bence-sebok/thesis/pictures/dht22 data waveform.png

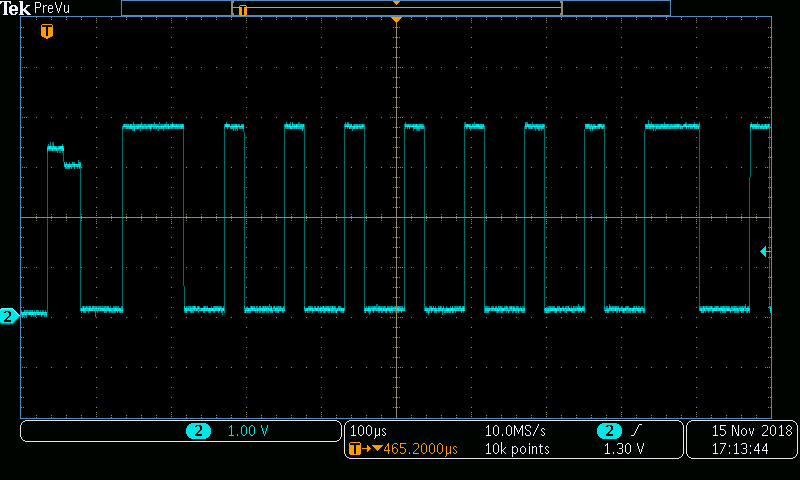
pictures/dht22 data waveform.png
