bence-sebok/thesis/pictures/ezr32lg_board.png

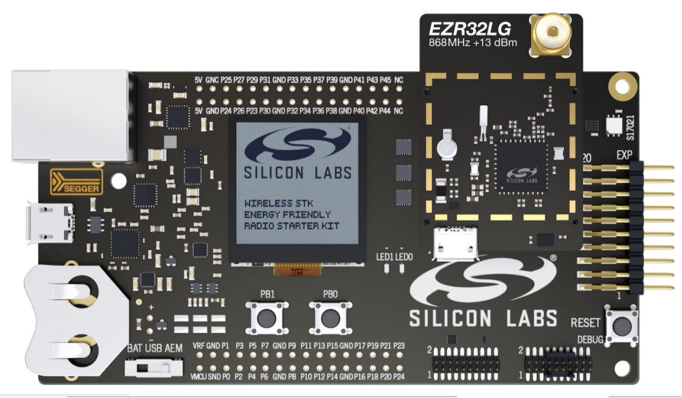
pictures/ezr32lg_board.png
