bence-sebok/thesis/pictures/i2c waveform 3.png

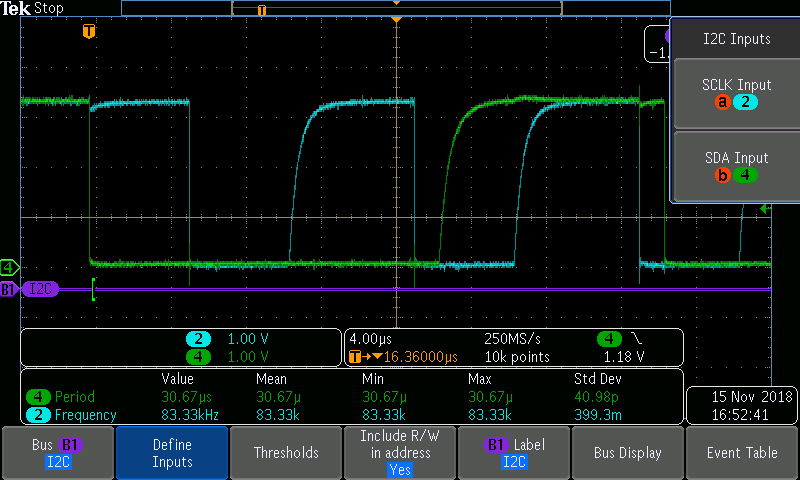
pictures/i2c waveform 3.png
