bence-sebok/thesis/pictures/i2c waveform.png

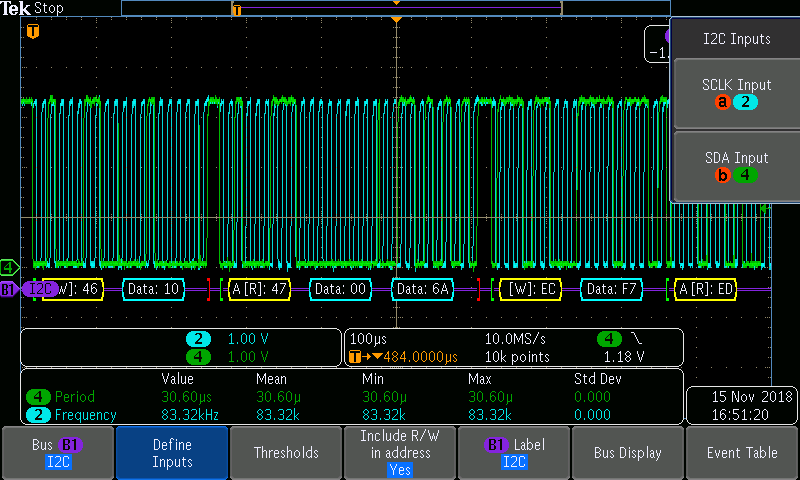
pictures/i2c waveform.png
