bence-sebok/thesis/pictures/img_bh1750_block.png

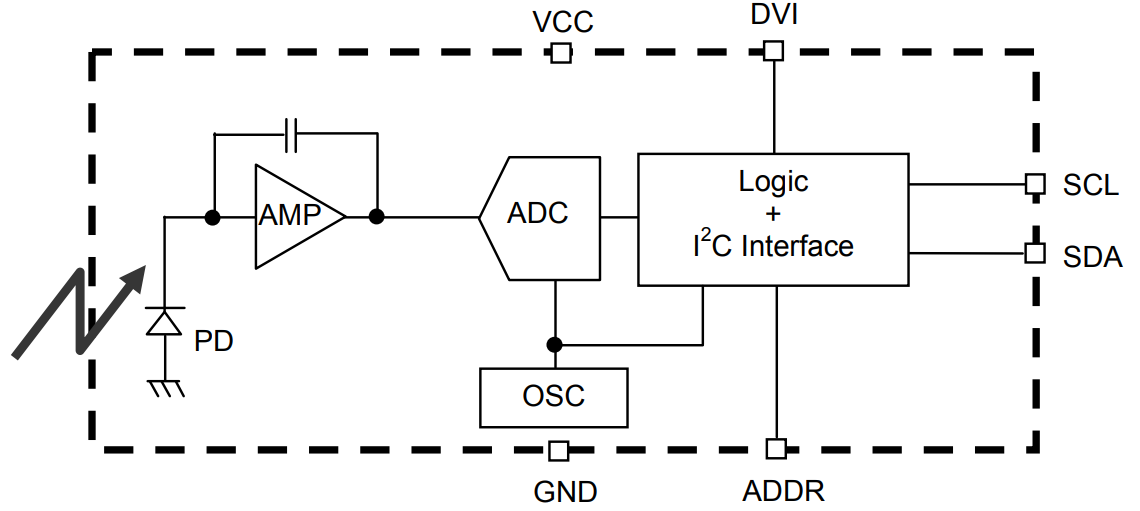
pictures/img_bh1750_block.png
