bence-sebok/thesis/pictures/img_bh1750_mode.png

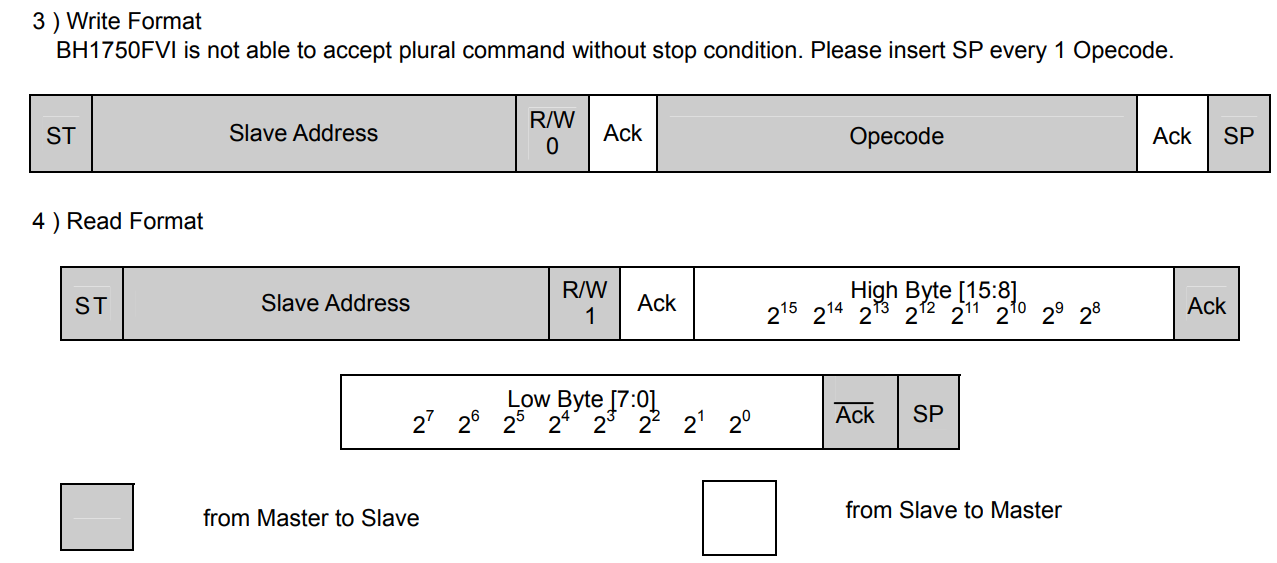
pictures/img_bh1750_mode.png
