bence-sebok/thesis/pictures/img_bh1750fvi.png

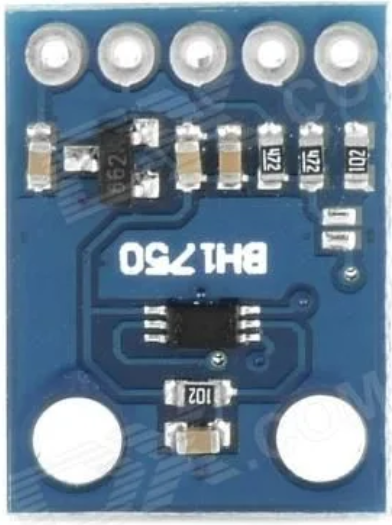
pictures/img_bh1750fvi.png
