bence-sebok/thesis/pictures/img_bmp280.png

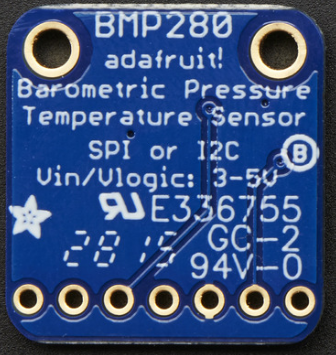
pictures/img_bmp280.png
