bence-sebok/thesis/pictures/img_bmp280_block.png

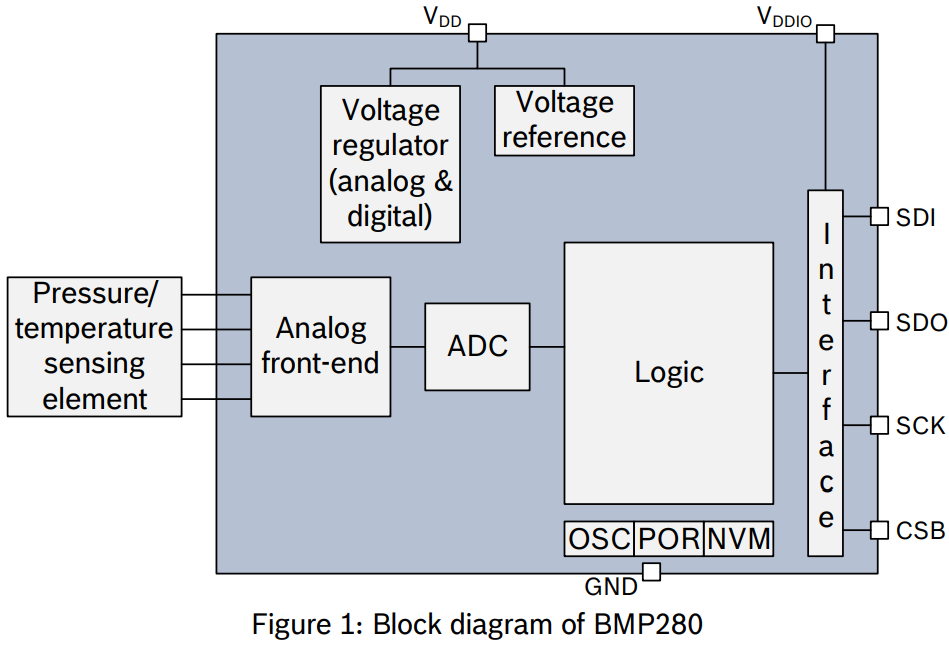
pictures/img_bmp280_block.png
