bence-sebok/thesis/pictures/img_bmp280_meas.png

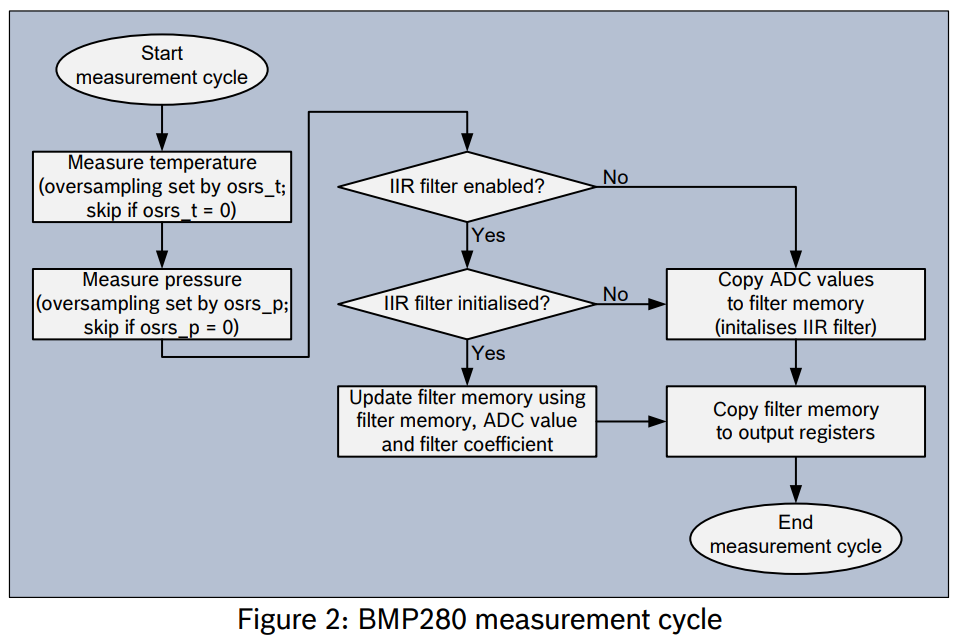
pictures/img_bmp280_meas.png
