bence-sebok/thesis/pictures/img_dht22.png

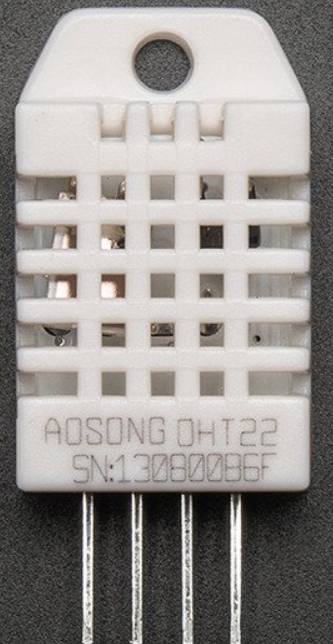
pictures/img_dht22.png
