bence-sebok/thesis/pictures/img_fsk.png

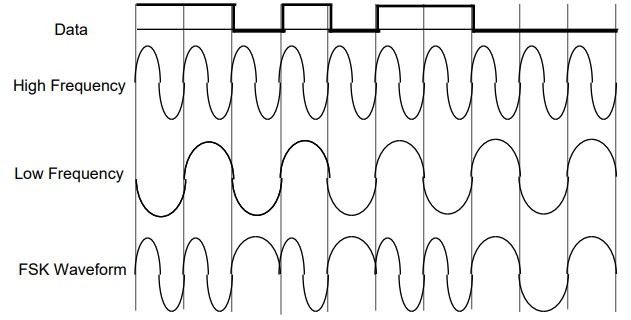
pictures/img_fsk.png
