bence-sebok/thesis/software/gecko/thesis_gecko/inc/hardware_config.h

/*
 * hardware_config.h
 *
 *  Created on: Nov 15, 2018
 *      Author: sebokbence
 */

#ifndef INC_HARDWARE_CONFIG_H_
#define INC_HARDWARE_CONFIG_H_

#define I2C0_SDA_PORT (gpioPortD)
#define I2C0_SDA_PIN (6U)
#define I2C0_SCL_PORT (gpioPortD)
#define I2C0_SCL_PIN (7U)

#endif /* INC_HARDWARE_CONFIG_H_ */
