bence-sebok/thesis/software/gecko/thesis_gecko/src/main.c

/***************************************************************************//**
 * @file main.c
 * @brief EZRadio simple trx example
 *
 * This example shows how to easily implement a simple trx code for your
 * controller using EZRadio or EZRadioPRO devices.
 *
 * @version 5.2.2
 *******************************************************************************
 * # License
 * <b>Copyright 2015 Silicon Labs, Inc. http://www.silabs.com</b>
 *******************************************************************************
 *
 * Permission is granted to anyone to use this software for any purpose,
 * including commercial applications, and to alter it and redistribute it
 * freely, subject to the following restrictions:
 *
 * 1. The origin of this software must not be misrepresented; you must not
 *    claim that you wrote the original software.
 * 2. Altered source versions must be plainly marked as such, and must not be
 *    misrepresented as being the original software.
 * 3. This notice may not be removed or altered from any source distribution.
 *
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
 * Silicon Labs will not be liable for any consequential, incidental, or
 * special damages, or any other relief, or for any claim by any third party,
 * arising from your use of this Software.
 *
 ******************************************************************************/

//#define THESIS_TEST
#define USING_DISPLAY

#include <stdint.h>
#include <stdbool.h>
#include <stdio.h>
#include <stdlib.h>
#include <string.h>

#include "spidrv.h"
#include "em_device.h"
#include "em_chip.h"
#include "em_cmu.h"
#include "em_emu.h"
#include "em_gpio.h"
#include "em_i2c.h"
#include "em_timer.h"
#include "gpiointerrupt.h"
#include "rtcdriver.h"
#include "udelay.h"

#include "ezradio_cmd.h"
#include "ezradio_api_lib.h"
#include "ezradio_plugin_manager.h"

#include "display.h"
#include "textdisplay.h"
#include "retargettextdisplay.h"
#include "bspconfig.h"
#include "image.h"

// Header files for sensors
#include "hardware_config.h"
#include "FH1750.h"
#include "BMP280.h"
#include "DHT22.h"

int8_t BMP280_CHIPID_VALUE[1] = {0};
uint16_t chipidSize = 1;

int8_t BMP280_CONFIG[2] = {0};
uint16_t sizeConfig = 2;

uint32_t bmp280_pressure = 0;
int32_t bmp280_temperature = 0;
double bmp280_temperature_C = 0.0;

uint16_t lightLevel = 0;

uint8_t meas[6] = {0};

dht22_data_t dht22_data = {0};

struct bmp280_calib_param bmp280_parameters = {0};

volatile int32_t measurement_press = 0;
volatile int32_t measurement_temp = 0;

// FH1750 global variables
uint32_t rxBuffer[100];
uint8_t rxIndex = 0;
volatile uint8_t BH1750_MODE = CONTINUOUS_HIGH_RES_MODE;
volatile uint8_t BH1750_MTreg = 0;
const float BH1750_CONV_FACTOR = 1.2;

/* Display device */
static DISPLAY_Device_t displayDevice;

/* Image widht and height definitions */
#define IMAGE_HIGHT           62u
#define BYTES_PER_LINE        (LS013B7DH03_WIDTH / 8)
#define BYTES_PER_FRAME       (IMAGE_HIGHT * BYTES_PER_LINE)

/* Push button callback functionns. */
static void GPIO_PB1_IRQHandler(uint8_t pin);
static void GPIO_PB0_IRQHandler(uint8_t pin);

#if (defined EZRADIO_VARIABLE_DATA_START)
#define APP_PKT_DATA_START EZRADIO_VARIABLE_DATA_START
#else
#define APP_PKT_DATA_START 1u
#endif

#if (defined EZRADIO_PLUGIN_TRANSMIT)
static void appPacketTransmittedCallback (EZRADIODRV_Handle_t handle, Ecode_t status);
#endif //#if ( defined EZRADIO_PLUGIN_TRANSMIT )

#if (defined EZRADIO_PLUGIN_RECEIVE)
static void appPacketReceivedCallback (EZRADIODRV_Handle_t handle, Ecode_t status);
#endif //#if ( defined EZRADIO_PLUGIN_RECEIVE )

#if (defined EZRADIO_PLUGIN_CRC_ERROR)
static void appPacketCrcErrorCallback (EZRADIODRV_Handle_t handle, Ecode_t status);
#endif //#if ( defined EZRADIO_PLUGIN_CRC_ERROR )

#if !defined(__CROSSWORKS_ARM) && defined(__GNUC__)
/* sniprintf does not process floats, but occupy less flash memory ! */
#define snprintf    sniprintf
#endif

#if (defined EZRADIO_PLUGIN_TRANSMIT)

/* Defines the number of packets to send for one press of PB1.
 * Sends infinite number of packets if defined to 0xFFFF. */
#define APP_TX_PKT_SEND_NUM   0xFFFF

/* Tx packet data array, initialized with the default payload in the generated header file */
static uint8_t radioTxPkt[EZRADIO_FIFO_SIZE] = RADIO_CONFIG_DATA_CUSTOM_PAYLOAD;

/* Packet counter */
static volatile uint16_t appTxPktCntr = 0;

/* Sign tx active state */
static volatile bool appTxActive = false;

/* Data counter in transmitted packet */
static volatile uint16_t appDataCntr = 0;

#endif //#if ( defined EZRADIO_PLUGIN_TRANSMIT )

#if (defined EZRADIO_PLUGIN_RECEIVE)

/* Rx packet data array */
static uint8_t radioRxPkt[EZRADIO_FIFO_SIZE];

#endif //#if ( defined EZRADIO_PLUGIN_RECEIVE )

/* RTC frequency */
#if defined(_EZR32_HAPPY_FAMILY)
#define APP_RTC_FREQ_HZ 4u
#else
#define APP_RTC_FREQ_HZ 9u
#endif

/* RTC timeout */
#define APP_RTC_TIMEOUT_MS (1000u / APP_RTC_FREQ_HZ)

/* RTC set time is expired */
static volatile bool rtcTick = false;

/** Timer used to issue time elapsed interrupt. */
static RTCDRV_TimerID_t rtcTickTimer;
static RTCDRV_TimerID_t rtcRepeateTimer;

static volatile uint32_t timerTick = 0;
static volatile uint8_t measurementFlag = 0;

/**************************************************************************//**
 * @brief
 *    TIMER initialization
 *****************************************************************************/
// Note: change this to set the desired output frequency in Hz
#define TIMER_FREQ (0.2)
void initTimer(void)
{
  // Enable clock for TIMER0 module
  CMU_ClockEnable(cmuClock_TIMER1, true);

  // Initialize the timer
  TIMER_Init_TypeDef timerInit = TIMER_INIT_DEFAULT;
  timerInit.prescale = _TIMER_CTRL_PRESC_DIV1024;
  TIMER_Init(TIMER1, &timerInit);

  // Set top value to overflow at the desired PWM_FREQ frequency
  TIMER_TopSet(TIMER1,  250000000);


  // Enable TIMER0 compare event interrupts to update the duty cycle
  TIMER_IntEnable(TIMER1, TIMER_IEN_OF);
  NVIC_EnableIRQ(TIMER1_IRQn);
}

/**************************************************************************//**
 * @brief
 *    Interrupt handler for TIMER1 that changes the duty cycle
 *******************************************************************************/
void TIMER1_IRQHandler(void)
{
  // Acknowledge the interrupt
  uint32_t flags = TIMER_IntGet(TIMER1);
  TIMER_IntClear(TIMER1, flags);
  timerTick++;
  if(timerTick > 10)
  {
	  measurementFlag = 1;
	  GPIO_PinOutToggle(gpioPortF, 6);
	  timerTick = 0;
  }
}

/***************************************************************************//**
 * @brief Setup GPIO interrupt for pushbuttons.
 ******************************************************************************/
static void GpioSetup(void)
{
  /* Enable GPIO clock */
  CMU_ClockEnable(cmuClock_GPIO, true);

  /* Initialize GPIO interrupt */
  GPIOINT_Init();

  /* Configure PB0 as input and enable interrupt */
  GPIO_PinModeSet(BSP_GPIO_PB0_PORT, BSP_GPIO_PB0_PIN, gpioModeInputPull, 1);
  GPIO_IntConfig(BSP_GPIO_PB0_PORT, BSP_GPIO_PB0_PIN, false, true, true);
  GPIOINT_CallbackRegister(BSP_GPIO_PB0_PIN, GPIO_PB0_IRQHandler);

  /* Configure PB1 as input and enable interrupt */
  GPIO_PinModeSet(BSP_GPIO_PB1_PORT, BSP_GPIO_PB1_PIN, gpioModeInputPull, 1);
  GPIO_IntConfig(BSP_GPIO_PB1_PORT, BSP_GPIO_PB1_PIN, false, true, true);
  GPIOINT_CallbackRegister(BSP_GPIO_PB1_PIN, GPIO_PB1_IRQHandler);

  // DHT22 sensor GPIO settings
  GPIO_PinModeSet(DHT22_DATA_PORT, DHT22_DATA_PIN, gpioModeInputPull, 1); // Pull up

  GPIO_PinModeSet(gpioPortF, 6, gpioModePushPull, 1); // User LED0
  GPIO_PinModeSet(gpioPortF, 7, gpioModePushPull, 0); // User LED1
}

/***************************************************************************//**
 * @brief GPIO Interrupt handler (PB1)
 *        Switches between analog and digital clock modes.
 ******************************************************************************/
static void GPIO_PB0_IRQHandler(uint8_t pin)
{
  (void)pin;

#if (defined EZRADIO_PLUGIN_TRANSMIT)
  /* Check if already transmitting some packets,
   * send one otherwise. */
  if ( !appTxPktCntr ) {
    appTxPktCntr += 1;
  }
#endif //#if ( defined EZRADIO_PLUGIN_TRANSMIT )
}

static void doMeasurement(void)
{
	int i;
	int empty = false;
	GPIO_PinOutSet(gpioPortF, 7);
	BH1750_readLightLevel(1000, &lightLevel);
	BMP280_I2C_ReadRegister(0xF7, (int8_t*)meas, 6);
	for(i = 0; i < 6; i++)
	{
		if(meas[i] != 0)
		{
			empty = true;
		}
	}
	if(!empty)
	{
		meas[0] = 0b111;
		meas[1] = 0b11101110;
		meas[3] = 0b11010000;
		meas[4] = 0b110;
		meas[5] = 0b01010101;
		meas[6] = 0b10101100;
	}
	measurement_press = (int32_t) (((uint32_t)meas[0] << 12) | ((uint32_t)meas[1] << 4) | ((uint32_t)meas[2] >> 4));
	measurement_temp = (int32_t) (((int32_t)meas[3] << 12) | ((int32_t)meas[4] << 4) | ((int32_t)meas[5] >> 4));
	bmp280_temperature = BMP280_CompensateTemperature(measurement_temp, &bmp280_parameters);
	bmp280_pressure = BMP280_CompensatePressure(measurement_press, &bmp280_parameters);
	bmp280_temperature_C = ((double)bmp280_temperature) / 100;
	if(DHT22_ReadSensor(&dht22_data))
	{
		DHT22_GetTemperature(&dht22_data);
		DHT22_GetHumidity(&dht22_data);
		DHT22_ComputeHeatIndex(&dht22_data);
	}
	memset(radioTxPkt, 0, 64);
	/* Add data cntr as the data to be sent to the packet */
	// Light level
	radioTxPkt[APP_PKT_DATA_START]   = (uint8_t)( ((uint16_t)lightLevel) >> 8);
	radioTxPkt[APP_PKT_DATA_START + 1] = (uint8_t)( ((uint16_t)lightLevel) & 0x00FF);
	// BMP280 temperature
	radioTxPkt[APP_PKT_DATA_START + 2]   = (uint8_t)( ((uint16_t)(bmp280_temperature)) >> 24 & 0x00FF);
	radioTxPkt[APP_PKT_DATA_START + 3]   = (uint8_t)( ((uint16_t)(bmp280_temperature)) >> 16 & 0x00FF);
	radioTxPkt[APP_PKT_DATA_START + 4]   = (uint8_t)( ((uint16_t)(bmp280_temperature)) >> 8 & 0x00FF);
	radioTxPkt[APP_PKT_DATA_START + 5]   = (uint8_t)( ((uint16_t)(bmp280_temperature)) >> 0 & 0x00FF);
	// BMP280 pressure
	radioTxPkt[APP_PKT_DATA_START + 6]   = (uint8_t)( ((uint16_t)(bmp280_pressure)) >> 24 & 0x00FF);
	radioTxPkt[APP_PKT_DATA_START + 7]   = (uint8_t)( ((uint16_t)(bmp280_pressure)) >> 16 & 0x00FF);
	radioTxPkt[APP_PKT_DATA_START + 8]   = (uint8_t)( ((uint16_t)(bmp280_pressure)) >> 8 & 0x00FF);
	radioTxPkt[APP_PKT_DATA_START + 9]   = (uint8_t)( ((uint16_t)(bmp280_pressure)) >> 0 & 0x00FF);
	/*
	memset(radioTxPkt, 0, 64);
	radioTxPkt[APP_PKT_DATA_START]   = (uint8_t)( ((uint16_t)1) >> 8);
	radioTxPkt[APP_PKT_DATA_START + 1] = (uint8_t)( ((uint16_t)1) & 0x00FF);
	// BMP280 temperature
	radioTxPkt[APP_PKT_DATA_START + 2]   = (uint8_t)( ((uint16_t)(2 / 100)) >> 8);
	radioTxPkt[APP_PKT_DATA_START + 3] = (uint8_t)( ((uint16_t)(2 % 100)) & 0x00FF);
	// BMP280 pressure
	radioTxPkt[APP_PKT_DATA_START + 4]   = (uint8_t)( ((uint16_t)(3 / 100)) >> 8);
	radioTxPkt[APP_PKT_DATA_START + 5] = (uint8_t)( ((uint16_t)(3 % 100)) & 0x00FF);
	*/
	GPIO_PinOutClear(gpioPortF, 7);
	appTxPktCntr += 1;
}

/***************************************************************************//**
 * @brief GPIO Interrupt handler (PB0)
 *        Increments the time by one minute.
 ******************************************************************************/
static void GPIO_PB1_IRQHandler(uint8_t pin)
{
  (void)pin;

#if (defined EZRADIO_PLUGIN_TRANSMIT)
  /* Check if already transmitting some packets, stop them if so,
   * otherwise, send the APP_TX_PKT_SEND_NUM number of packets
   * (infinite is defined to 0xFFFF). */
  /*
  if (appTxPktCntr) {
    appTxPktCntr = 0;
  } else {
    appTxPktCntr += APP_TX_PKT_SEND_NUM;
  }
  */
#endif //#if ( defined EZRADIO_PLUGIN_TRANSMIT )
}

/***************************************************************************//**
 * @brief Draws Silicon Labs logo.
 ******************************************************************************/
void drawPicture(void)
{
  char *pFrame;

  /* Retrieve the properties of the display. */
  if ( DISPLAY_DeviceGet(0, &displayDevice) != DISPLAY_EMSTATUS_OK) {
    while (1) ;
  }

  /* Load pointer to picture buffor */
  pFrame = (char *) image_bits;

  /* Write to LCD */
  displayDevice.pPixelMatrixDraw(&displayDevice, pFrame,
                                 /* start coloumn, width */
                                 0, displayDevice.geometry.width,
                                 /* start row, height */
                                 0, IMAGE_HIGHT);
}

/***************************************************************************//**
 * @brief   Register a callback function to be called repeatedly at the
 *          specified frequency.
 *
 * @param[in] pFunction  Pointer to function that should be called at the
 *                       given frequency.
 * @param[in] pParameter Pointer argument to be passed to the callback function.
 * @param[in] frequency  Frequency at which to call function at.
 *
 * @return  0 for successful or
 *         -1 if the requested frequency is not supported.
 ******************************************************************************/
int RepeatCallbackRegister(void(*pFunction)(void*),
                           void* pParameter,
                           unsigned int frequency)
{
  if (ECODE_EMDRV_RTCDRV_OK
      == RTCDRV_AllocateTimer(&rtcRepeateTimer)) {
    if (ECODE_EMDRV_RTCDRV_OK
        == RTCDRV_StartTimer(rtcRepeateTimer, rtcdrvTimerTypePeriodic, frequency,
                             (RTCDRV_Callback_t)pFunction, pParameter)) {
      return 0;
    }
  }

  return -1;
}

/***************************************************************************//**
 * @brief GPIO Interrupt handler (PB0)
 *        Increments the time by one minute.
 ******************************************************************************/
void RTC_App_IRQHandler()
{
  rtcTick = true;
}

void initI2C(void)
{
  int i;
  CMU_Clock_TypeDef i2cClock;
  I2C_Init_TypeDef i2cInit = I2C_INIT_DEFAULT;

  CMU_ClockEnable(cmuClock_HFPER, true);
  /* Select I2C peripheral clock */
  i2cClock = cmuClock_I2C0;
  CMU_ClockEnable(i2cClock, true);

  /* Output value must be set to 1 to not drive lines low. Set
	 SCL first, to ensure it is high before changing SDA. */
  GPIO_PinModeSet(gpioPortD, 7, gpioModeWiredAndPullUp, 1);
  GPIO_PinModeSet(gpioPortD, 6, gpioModeWiredAndPullUp, 1);

  /* In some situations, after a reset during an I2C transfer, the slave
	 device may be left in an unknown state. Send 9 clock pulses to
	 set slave in a defined state. */
  for (i = 0; i < 9; i++) {
	GPIO_PinOutSet(gpioPortD, 7);
	GPIO_PinOutClear(gpioPortD, 7);
  }

  /* Enable pins and set location */
  I2C0->ROUTE = I2C_ROUTE_SDAPEN | I2C_ROUTE_SCLPEN | (1 << _I2C_ROUTE_LOCATION_SHIFT);

  I2C_Init(I2C0, &i2cInit);
}

/***************************************************************************//**
 * @brief  Main function of the example.
 ******************************************************************************/
int main(void)
{
  /* EZRadio driver init data and handler */
  EZRADIODRV_HandleData_t appRadioInitData = EZRADIODRV_INIT_DEFAULT;
  EZRADIODRV_Handle_t appRadioHandle = &appRadioInitData;

  /* EZRadio response structure union */
  ezradio_cmd_reply_t ezradioReply;

  uint8_t BMP280_RESET[1] = {0xB6};

  /* Chip errata */
  CHIP_Init();

  /* HFXO 48MHz, divided by 1 */
  CMU_ClockSelectSet(cmuClock_HF, cmuSelect_HFXO);
  UDELAY_Calibrate();

  /* Setup GPIO for pushbuttons. */
  GpioSetup();

  initI2C();

  BH1750_Configure(CONTINUOUS_HIGH_RES_MODE);
  BMP280_I2C_ReadRegister(BMP280_CHIPID_REGISTER, BMP280_CHIPID_VALUE, chipidSize);
  if(BMP280_CHIPID_VALUE[0] == 88 || BMP280_CHIPID_VALUE[0] == 0x58)
  {
	  BMP280_I2C_WriteRegister(0xE0, (int8_t*)BMP280_RESET, 1);
  }
  UDELAY_Delay(1000);
  UDELAY_Delay(1000);
  UDELAY_Delay(1000);
  UDELAY_Delay(1000);
  UDELAY_Delay(1000);
  BMP280_I2C_ReadRegister(BMP280_CHIPID_REGISTER, BMP280_CHIPID_VALUE, chipidSize);
  BMP280_GetCalibrationParameters(&bmp280_parameters);
  BMP280_I2C_ReadRegister(0xF4, BMP280_CONFIG, sizeConfig);
  delay_ms(1000);
  BMP280_CONFIG[0] = ((0x05 << 2) | (0x03 << 5));
  BMP280_CONFIG[1] = ((0x05 << 5) | (0x01 << 2));
  BMP280_I2C_WriteRegister(0xF4, BMP280_CONFIG, 2);
  BMP280_CONFIG[0] = ((0x05 << 2) | (0x03 << 5) | (0x03));
  BMP280_I2C_WriteRegister(0xF4, BMP280_CONFIG, 2);

#ifdef THESIS_TEST
  while(1)
  {
	  doMeasurement();
  }
#endif

  initTimer();

  //BMP280_SetExampleCalibrationParameters(&bmp280_parameters);

  /* Initialize the display module. */
#ifndef USING_DISPLAY
  DISPLAY_Init();
#endif

#ifndef USING_DISPLAY
  /* Retarget stdio to the display. */
  if (TEXTDISPLAY_EMSTATUS_OK != RETARGET_TextDisplayInit()) {
    /* Text display initialization failed. */
    while (1) ;
  }
#endif

  /* Set RTC to generate interrupt 250ms. */
  RTCDRV_Init();
  if (ECODE_EMDRV_RTCDRV_OK
      != RTCDRV_AllocateTimer(&rtcTickTimer) ) {
    while (1) ;
  }
  if (ECODE_EMDRV_RTCDRV_OK
      != RTCDRV_StartTimer(rtcTickTimer, rtcdrvTimerTypePeriodic, APP_RTC_TIMEOUT_MS,
                           (RTCDRV_Callback_t)RTC_App_IRQHandler, NULL) ) {
    while (1) ;
  }

#ifndef USING_DISPLAY
  /* Print header */
  printf("\n\n\n\n\n\n\n\n  EZRadio Simple TRx\n");
#endif

#if (defined EZRADIO_PLUGIN_TRANSMIT)
  /* Configure packet transmitted callback. */
  appRadioInitData.packetTx.userCallback = &appPacketTransmittedCallback;
#endif

#if (defined EZRADIO_PLUGIN_RECEIVE)
  /* Configure packet received buffer and callback. */
  appRadioInitData.packetRx.userCallback = &appPacketReceivedCallback;
  appRadioInitData.packetRx.pktBuf = radioRxPkt;
#endif

#if (defined EZRADIO_PLUGIN_CRC_ERROR)
  /* Configure packet received with CRC error callback. */
  appRadioInitData.packetCrcError.userCallback = &appPacketCrcErrorCallback;
#endif

  /* Initialize EZRadio device. */
  ezradioInit(appRadioHandle);

  /* Print EZRadio device number. */
  ezradio_part_info(&ezradioReply);
#ifndef USING_DISPLAY
  printf("   Device: Si%04x\n\n", ezradioReply.PART_INFO.PART);
#endif

#ifndef USING_DISPLAY
#if (defined EZRADIO_PLUGIN_TRANSMIT)
  /* Print instructions. */
  printf(" Press PB0 to send\n  one packet.\n");
#if (APP_TX_PKT_SEND_NUM == 0xFFFF)
  printf(" Press PB1 to send\n  unlimited packets.\n");
#else
  printf(" Press PB1 to send\n  %d packets.\n", APP_TX_PKT_SEND_NUM);
#endif
#else //#if ( defined EZRADIO_PLUGIN_TRANSMIT )
  /* Print instructions. */
  printf(" Send packets by any\n transmitter node.\n");
#endif
  /* Draw logo */
  drawPicture();
#endif

  /* Reset radio fifos and start reception. */
  ezradioResetTRxFifo();
#if (defined EZRADIO_PLUGIN_RECEIVE)
  ezradioStartRx(appRadioHandle);
#endif

  /*
   * ****************************************************************************************
   * ****************************************************************************************
   * ****************************************************************************************
   */
  /* Enter infinite loop that will take care of ezradio plugin manager and packet transmission. */
  while (1) {
    /* Run radio plug-in manager */
    ezradioPluginManager(appRadioHandle);

    if(measurementFlag)
    {
    	doMeasurement();
    	measurementFlag = 0;
    }

    if (rtcTick) {
      rtcTick = false;

#if (defined EZRADIO_PLUGIN_TRANSMIT)
      /* Send a packet if requested */
      if (appTxPktCntr) {
        /* Try to send the packet */
        if ( !appTxActive ) {
          /* Sing tx active state */
          appTxActive = true;

          /* Transmit packet */
          ezradioStartTransmitDefault(appRadioHandle, radioTxPkt);

#ifndef USING_DISPLAY
          printf("<--Data TX: %05d\n", appDataCntr);
#endif

          /* Increase data counter */
          appDataCntr++;

          /* Decrease number of requested packets,
           * if not configured to infinite. */
          if (appTxPktCntr != 0xFFFF) {
            /* Decrease request counter */
            if (appTxPktCntr) {
              appTxPktCntr--;
            }
          }
        } else {
#ifndef USING_DISPLAY
          printf("---Data TX:  need to wait\n");
#endif
        }
      }
#endif //#if ( defined EZRADIO_PLUGIN_TRANSMIT )
    }
  }
}

#if (defined EZRADIO_PLUGIN_TRANSMIT)
/***************************************************************************//**
 * @brief  Packet transmitted callback of the application.
 *
 * @param[in] handle EzRadio plugin manager handler.
 * @param[in] status Callback status.
 ******************************************************************************/
static void appPacketTransmittedCallback(EZRADIODRV_Handle_t handle, Ecode_t status)
{
  if ( status == ECODE_EMDRV_EZRADIODRV_OK ) {
    /* Sign tx passive state */
    appTxActive = false;

#if (defined EZRADIO_PLUGIN_RECEIVE)
    /* Change to RX state */
    ezradioStartRx(handle);
#endif
  }
}
#endif //#if ( defined EZRADIO_PLUGIN_TRANSMIT )

#if (defined EZRADIO_PLUGIN_RECEIVE)
/***************************************************************************//**
 * @brief  Packet received callback of the application.
 *
 * @param[in] handle EzRadio plugin manager handler.
 * @param[in] status Callback status.
 ******************************************************************************/
static void appPacketReceivedCallback(EZRADIODRV_Handle_t handle, Ecode_t status)
{
  //Silent warning.
  (void)handle;

  if ( status == ECODE_EMDRV_EZRADIODRV_OK ) {
    /* Read out and print received packet data:
     *  - print 'ACK' in case of ACK was received
     *  - print the data if some other data was received. */
    if ( (radioRxPkt[APP_PKT_DATA_START] == 'A')
         && (radioRxPkt[APP_PKT_DATA_START + 1] == 'C')
         && (radioRxPkt[APP_PKT_DATA_START + 2] == 'K') ) {
#ifndef USING_DISPLAY
      printf("-->Data RX: ACK\n");
#endif
    } else {
      uint16_t rxLight;
      uint32_t rxTemp;
      uint32_t rxPres;

      rxLight =  (uint16_t)(radioRxPkt[APP_PKT_DATA_START]) << 8;
      rxLight += (uint16_t)(radioRxPkt[APP_PKT_DATA_START + 1]);
      rxTemp =  (uint16_t)(radioRxPkt[APP_PKT_DATA_START + 2]) << 24;
      rxTemp +=  (uint16_t)(radioRxPkt[APP_PKT_DATA_START + 3]) << 16;
      rxTemp +=  (uint16_t)(radioRxPkt[APP_PKT_DATA_START + 4]) << 8;
      rxTemp +=  (uint16_t)(radioRxPkt[APP_PKT_DATA_START + 5]) << 0;
      rxPres =  (uint16_t)(radioRxPkt[APP_PKT_DATA_START + 6]) << 24;
      rxPres +=  (uint16_t)(radioRxPkt[APP_PKT_DATA_START + 7]) << 16;
      rxPres +=  (uint16_t)(radioRxPkt[APP_PKT_DATA_START + 8]) << 8;
      rxPres +=  (uint16_t)(radioRxPkt[APP_PKT_DATA_START + 9]) << 0;

#ifndef USING_DISPLAY
      printf("Light: %d\n", rxLight);
      printf("Temp: %d\n", rxTemp);
      printf("Pres: %d\n", rxPres);
#endif
    }
  }
}
#endif //#if ( defined EZRADIO_PLUGIN_RECEIVE )

#if (defined EZRADIO_PLUGIN_CRC_ERROR)
/***************************************************************************//**
 * @brief  Packet received with CRC error callback of the application.
 *
 * @param[in] handle EzRadio plugin manager handler.
 * @param[in] status Callback status.
 ******************************************************************************/
static void appPacketCrcErrorCallback(EZRADIODRV_Handle_t handle, Ecode_t status)
{
  if ( status == ECODE_EMDRV_EZRADIODRV_OK ) {
#ifndef USING_DISPLAY
    printf("-->Pkt  RX: CRC Error\n");
#endif

#if (defined EZRADIO_PLUGIN_RECEIVE)
    /* Change to RX state */
    ezradioStartRx(handle);
#endif //#if ( defined EZRADIO_PLUGIN_RECEIVE )
  }
}
#endif //#if ( defined EZRADIO_PLUGIN_CRC_ERROR )
