bence-sebok/thesis/(commit log)

2018-11-02 Add kicad hardware project
    [thesis_kicad.kicad_pcb, thesis_kicad.sch]
2018-11-06 Update schematic with small fixes
    [thesis_kicad.sch]
2018-11-15 Working sensors with soldered PCB
2018-11-15 Remove incorrect parts from schematic
    [thesis_kicad.sch]
2018-11-26 Fix dht22 bug: missing int enable
    [DHT22.c, main.c]
2018-12-11 Add datasheets of sensors
